isaac879/RGB-Time-Fountain-V2/README.md

# RGB-Time-Fountain-V2

The RGB Time Fountain is water fountain that utilises the stroboscopic effect to create illusions of the water drops floating or even flowing upwards. Using precisely timed and synchronised red, green and blue strobe lights allows many beautiful and mesmerising illusions to be created. 

RGB Time Fountain Version 2 Project video: https://youtu.be/ambI007EriU

CAD and SVG files are available on thingyverse: https://www.thingiverse.com/isaac879/designs

The code required my custom library which is available here: https://github.com/isaac879/Iibrary

RGB Time Fountain prototype repository: https://github.com/isaac879/RGB-Time-Fountain

Prototype project video: https://youtu.be/LqMFiVkvxQw
