isaac879/RGB-Time-Fountain-V2/Schematic_RGB-Time-Fountain_V2.png

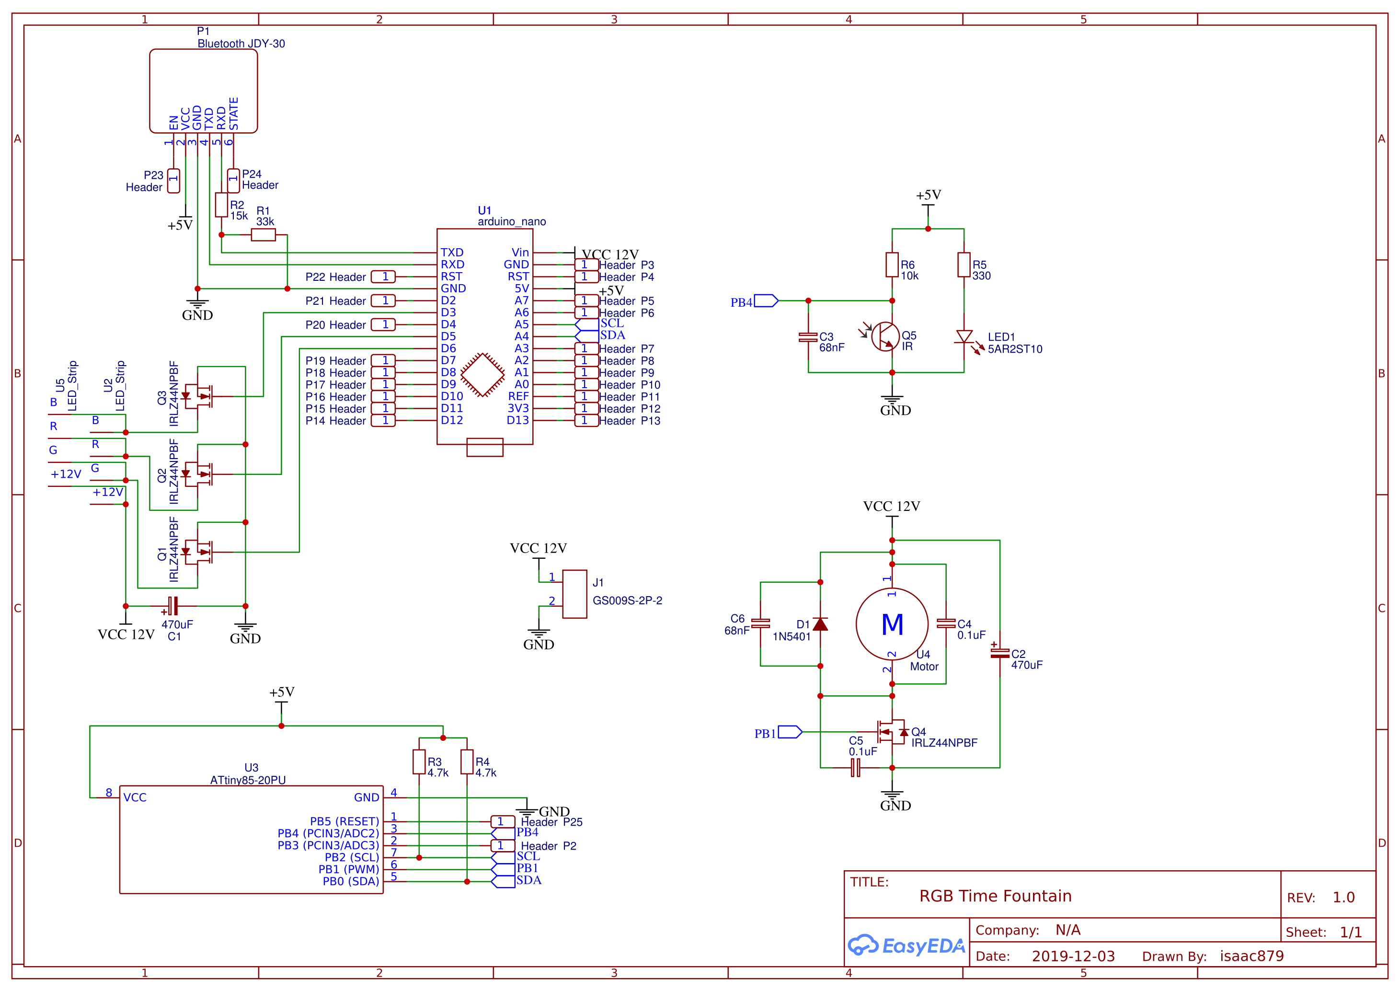
Schematic_RGB-Time-Fountain_V2.png
